blai30/pcbs/boards/fuji75-pcb/reference/j1-probe-guide.png

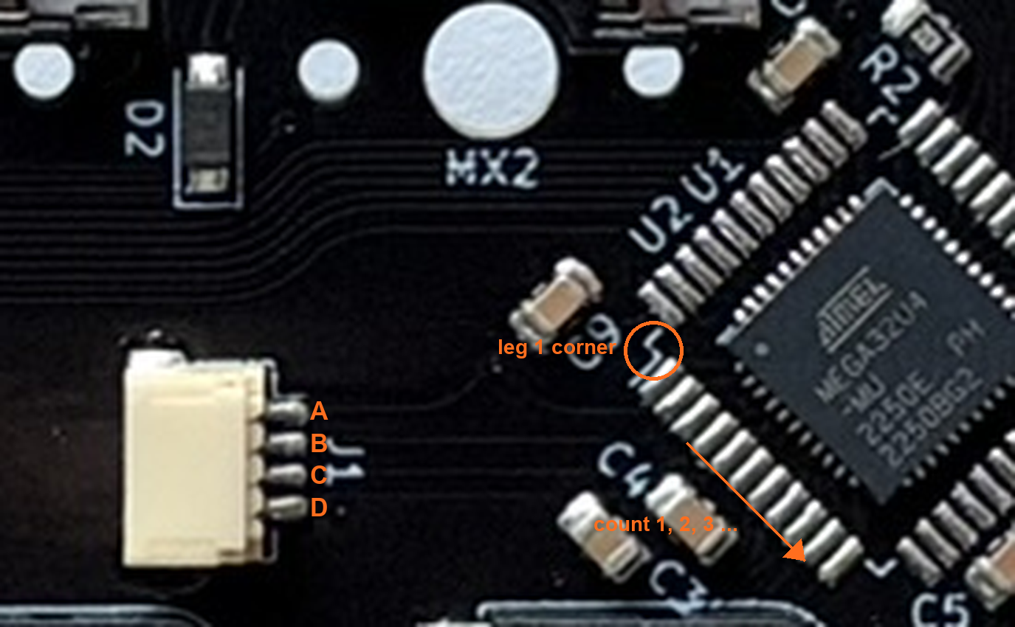
boards/fuji75-pcb/reference/j1-probe-guide.png
