blai30/pcbs/boards/fuji75-pcb/reference/photos/IMG_5499.JPEG

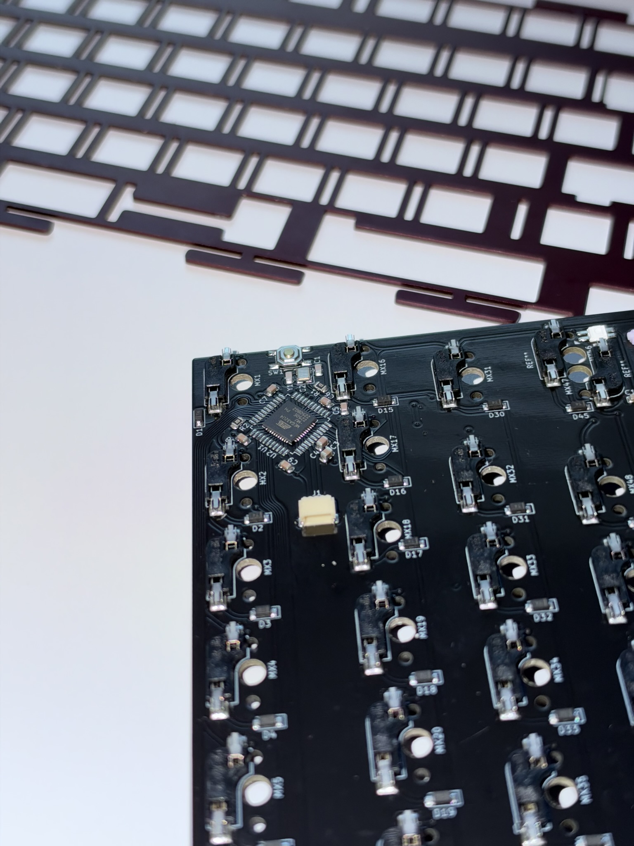
boards/fuji75-pcb/reference/photos/IMG_5499.JPEG
