blai30/pcbs/boards/fuji75-pcb/reference/keyboard-layout.png

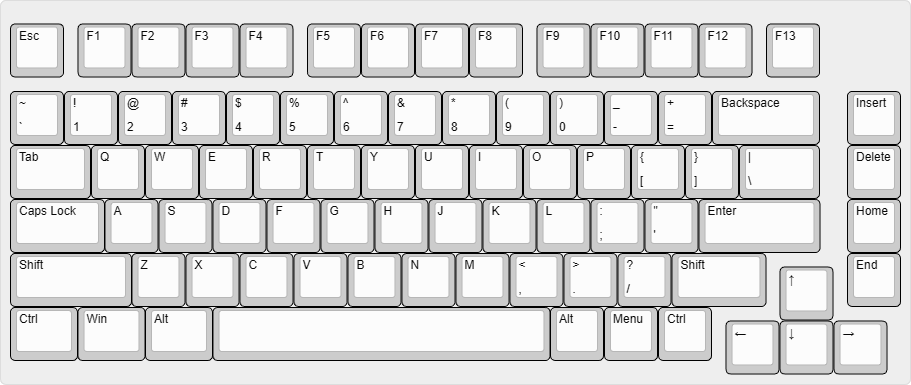
boards/fuji75-pcb/reference/keyboard-layout.png
