blai30/pcbs/boards/fuji75-pcb/reference/photos/IMG_5492.JPEG

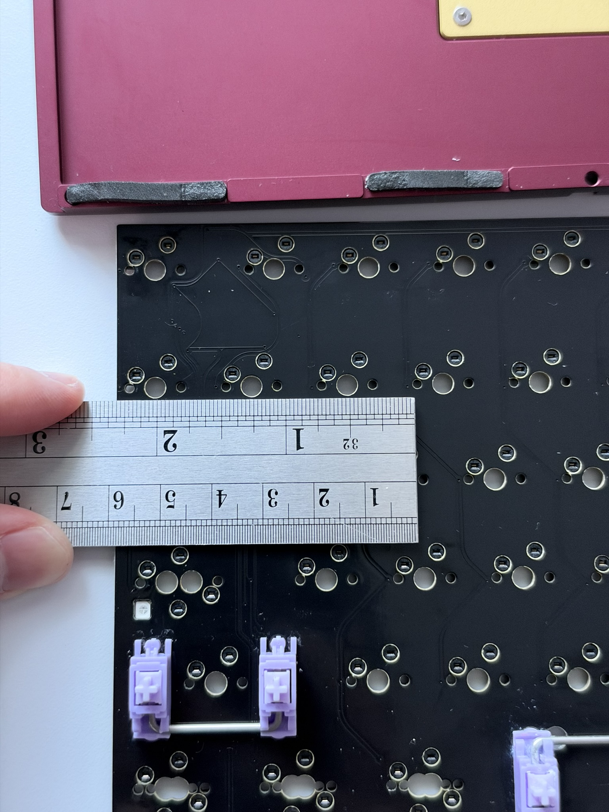
boards/fuji75-pcb/reference/photos/IMG_5492.JPEG
