blai30/pcbs/boards/fuji75-pcb/reference/photos/IMG_5493.JPEG

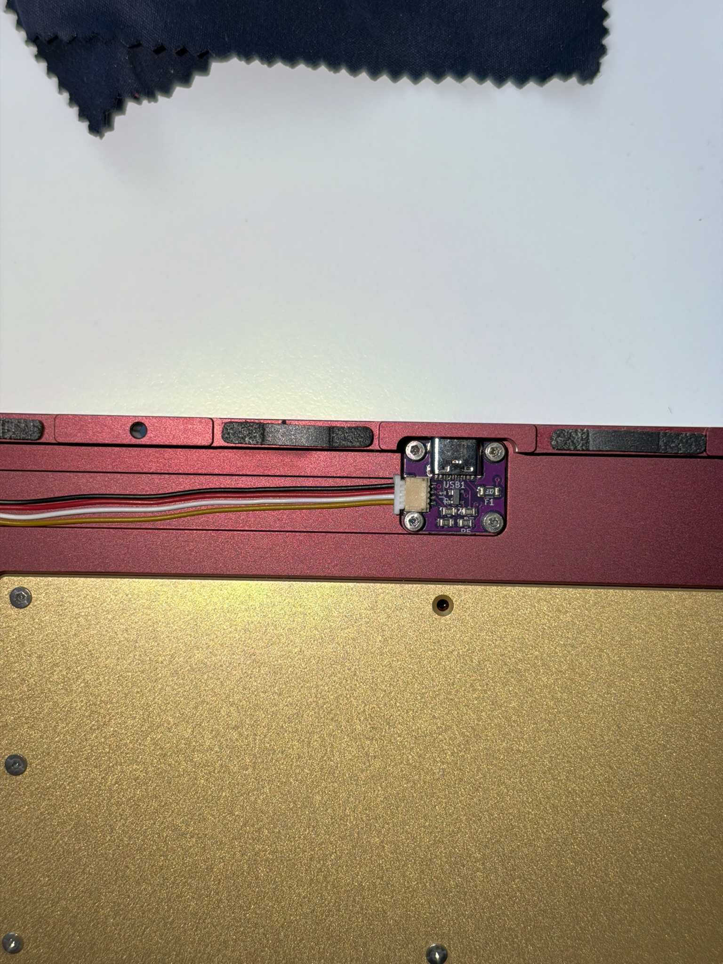
boards/fuji75-pcb/reference/photos/IMG_5493.JPEG
