blai30/pcbs/boards/fuji75-pcb/fuji75_plate.dxf

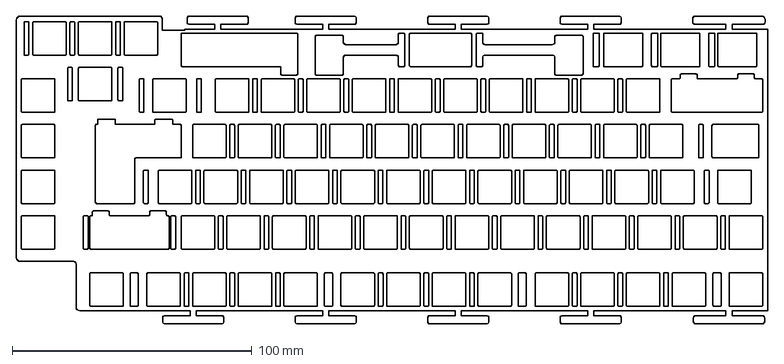
[picture p20: CAD file, 2026-11-05]
boards/fuji75-pcb/fuji75_plate.dxf
313.3 x 128.4 mm
