blai30/pcbs/boards/fuji75-pcb/plate/fuji75-plate-foam.dxf

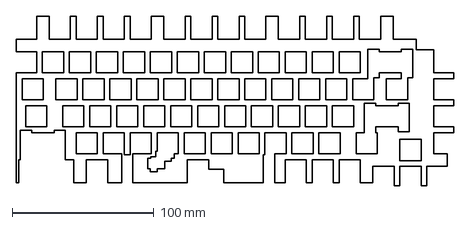
[picture p21: CAD file, 2026-11-10]
boards/fuji75-pcb/plate/fuji75-plate-foam.dxf
309.1 x 119.9 mm
