blai30/pcbs/boards/fuji75-pcb/reference/measurement-guide.png

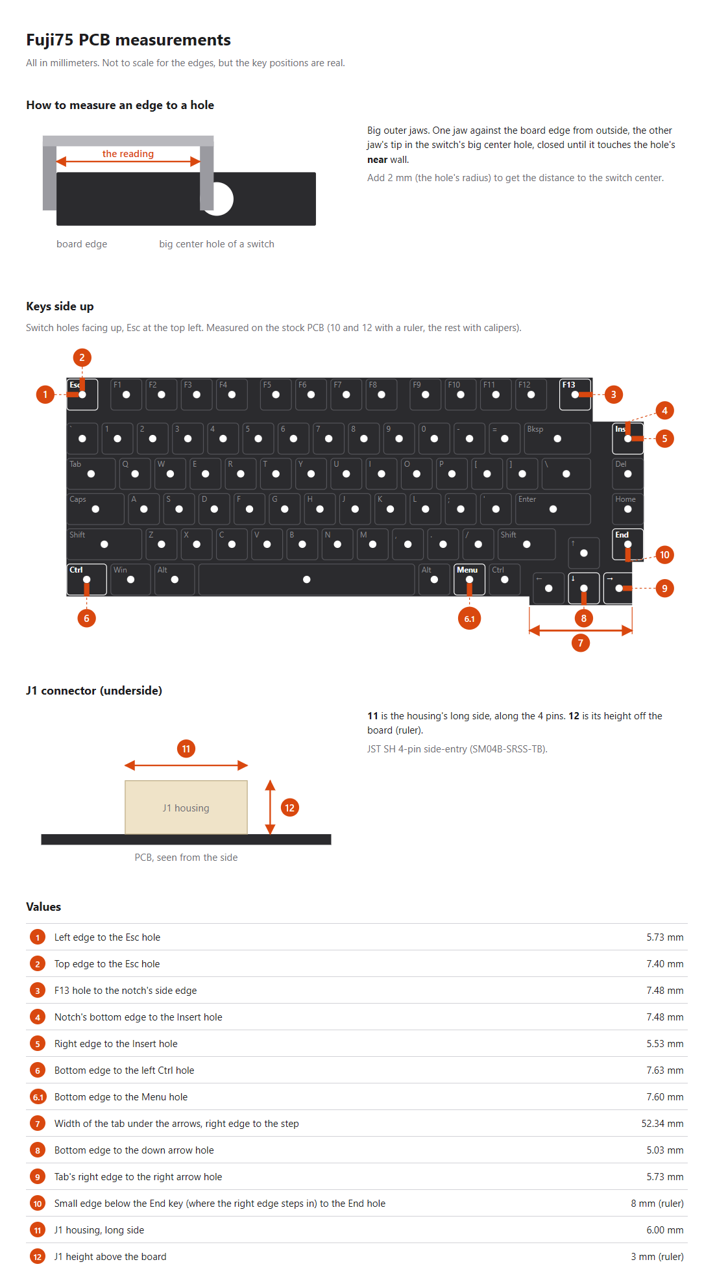
boards/fuji75-pcb/reference/measurement-guide.png
