blai30/pcbs/boards/fuji75-pcb/reference/measurements.md

# PCB edge distance
1. Left edge to near edge of ESC switch center hole: 5.73 mm
2. Top edge to near edge of ESC switch center hole: 7.40 mm
3. Indented right edge to near edge of F13 switch center hole: 7.48 mm
4. Indented top edge to near edge of Ins switch center hole: 7.48 mm
5. Right edge to near edge of Ins switch center hole: 5.53 mm
6. Bottom edge to near edge of Left Ctrl switch center hole: 7.63 mm
  6.1. Bottom edge to near edge of Right Menu switch center hole: 7.60 mm
7. Right edge to indented left edge; arrow keys plateau: 52.34 mm (calipers) / 52 mm (ruler)
8. Extended bottom edge to Down Arrow switch center hole: 5.03 mm
9. Short indented right edge to Right Arrow switch center hole: 5.73 mm
10. Indented bottom edge to End switch center hole: 8 mm (ruler)

# J1 connector
11. J1 connector housing long side: 6.00 mm
12. J1 connector housing height: 3 mm (ruler)
