blai30/pcbs/boards/fuji75-pcb/fuji75.kicad_pcb

## KiCad design boards/fuji75-pcb/fuji75.kicad_pcb (2026-11-06)

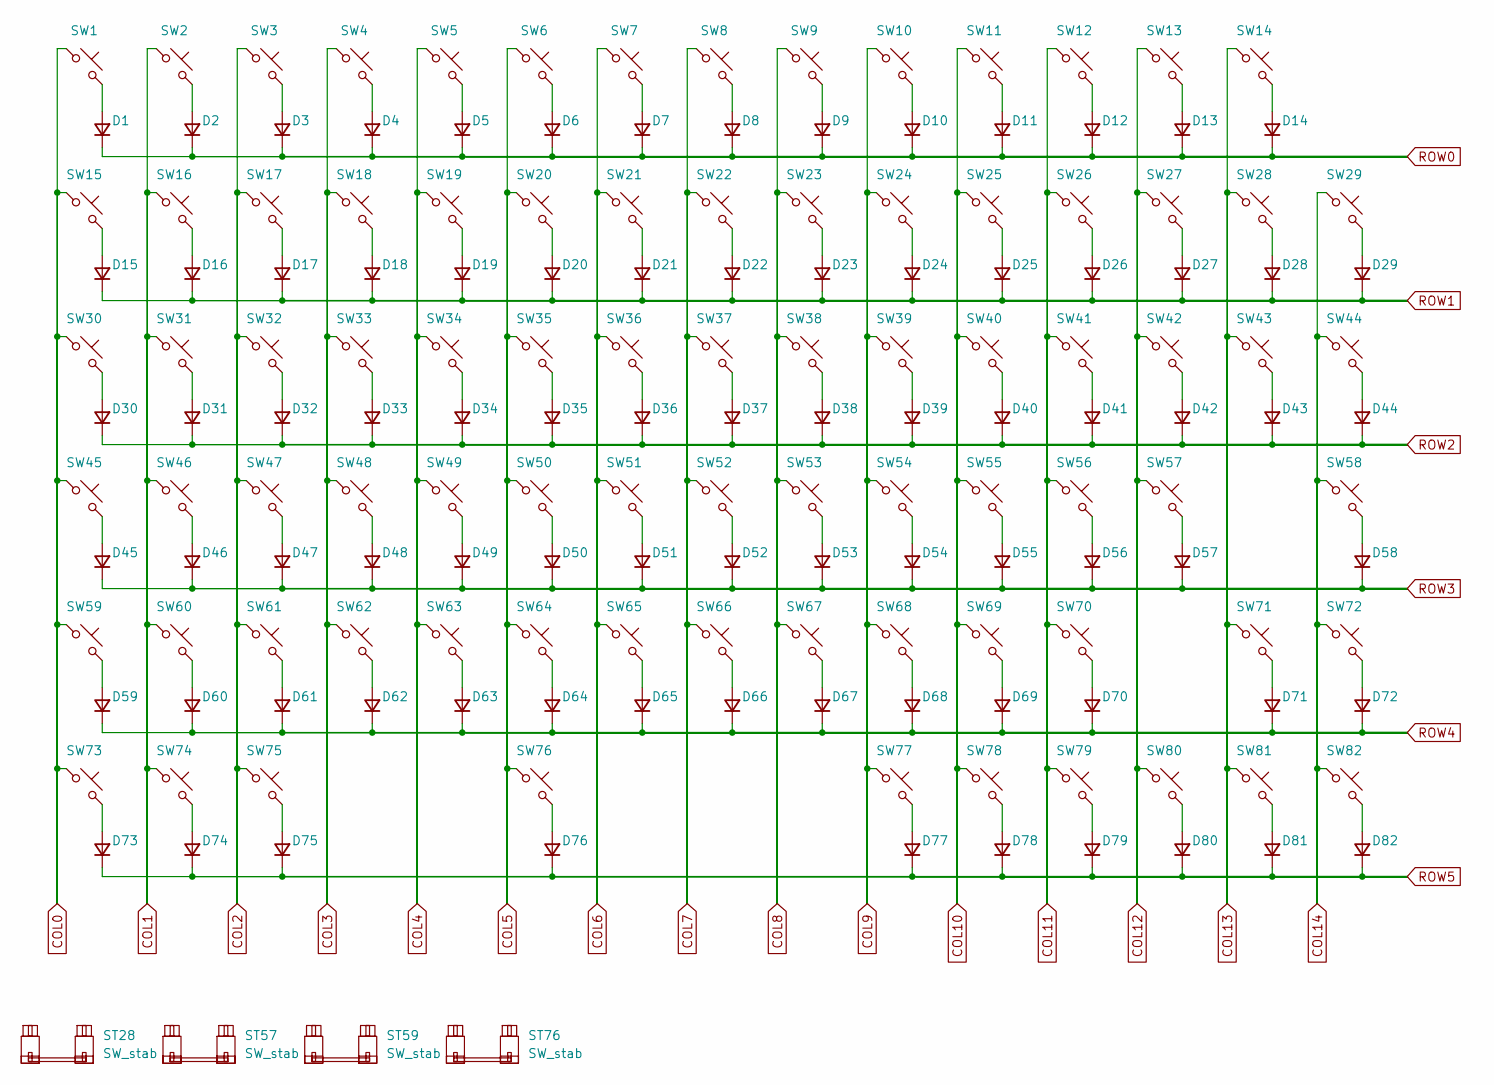
[picture p23: schematic fuji75-key-matrix.kicad_sch]

Parts:
D1, D2, D3, D4, D5, D6, D7, D8, D9, D10, D11, D12, D13, D14, D15, D16, D17, D18, D19, D20, D21, D22, D23, D24, D25, D26, D27, D28, D29, D30, D31, D32, D33, D34, D35, D36, D37, D38, D39, D40, D41, D42, D43, D44, D45, D46, D47, D48, D49, D50, D51, D52, D53, D54, D55, D56, D57, D58, D59, D60, D61, D62, D63, D64, D65, D66, D67, D68, D69, D70, D71, D72, D73, D74, D75, D76, D77, D78, D79, D80, D81, D82: D; D_SOD-123; MPN 1N4148W; LCSC C81598
ST28: SW_stab; STAB_MX_2u
ST57, ST59: SW_stab; STAB_MX_2.25u
ST76: SW_stab; STAB_MX_6.25u
SW1, SW2, SW3, SW4, SW5, SW6, SW7, SW8, SW9, SW10, SW11, SW12, SW13, SW14, SW15, SW16, SW17, SW18, SW19, SW20, SW21, SW22, SW23, SW24, SW25, SW26, SW27, SW28, SW29, SW31, SW32, SW33, SW34, SW35, SW36, SW37, SW38, SW39, SW40, SW41, SW42, SW44, SW46, SW47, SW48, SW49, SW50, SW51, SW52, SW53, SW54, SW55, SW56, SW57, SW58, SW59, SW60, SW61, SW62, SW63, SW64, SW65, SW66, SW67, SW68, SW69, SW71, SW72, SW76, SW77, SW78, SW79, SW80, SW81, SW82: SW_Push; SW_MX_HS_CPG151101S11_1u; MPN CPG151101S11; LCSC C2803348
SW30, SW43: SW_Push; SW_MX_HS_CPG151101S11_1.5u; MPN CPG151101S11; LCSC C2803348
SW45, SW70: SW_Push; SW_MX_HS_CPG151101S11_1.75u; MPN CPG151101S11; LCSC C2803348
SW73, SW74, SW75: SW_Push; SW_MX_HS_CPG151101S11_1.25u; MPN CPG151101S11; LCSC C2803348

Connections:
COL0: SW1.1, SW15.1, SW30.1, SW45.1, SW59.1, SW73.1; also elsewhere on the board
COL1: SW2.1, SW16.1, SW31.1, SW46.1, SW60.1, SW74.1; also elsewhere on the board
COL2: SW3.1, SW17.1, SW32.1, SW47.1, SW61.1, SW75.1; also elsewhere on the board
COL3: SW4.1, SW18.1, SW33.1, SW48.1, SW62.1; also elsewhere on the board
COL4: SW5.1, SW19.1, SW34.1, SW49.1, SW63.1; also elsewhere on the board
COL5: SW6.1, SW20.1, SW35.1, SW50.1, SW64.1, SW76.1; also elsewhere on the board
COL6: SW7.1, SW21.1, SW36.1, SW51.1, SW65.1; also elsewhere on the board
COL7: SW8.1, SW22.1, SW37.1, SW52.1, SW66.1; also elsewhere on the board
COL8: SW9.1, SW23.1, SW38.1, SW53.1, SW67.1; also elsewhere on the board
COL9: SW10.1, SW24.1, SW39.1, SW54.1, SW68.1, SW77.1; also elsewhere on the board
COL10: SW11.1, SW25.1, SW40.1, SW55.1, SW69.1, SW78.1; also elsewhere on the board
COL11: SW12.1, SW26.1, SW41.1, SW56.1, SW70.1, SW79.1; also elsewhere on the board
COL12: SW13.1, SW27.1, SW42.1, SW57.1, SW80.1; also elsewhere on the board
COL13: SW14.1, SW28.1, SW43.1, SW71.1, SW81.1; also elsewhere on the board
COL14: SW29.1, SW44.1, SW58.1, SW72.1, SW82.1; also elsewhere on the board
unnamed: D1.2 (A), SW1.2
unnamed: D2.2 (A), SW2.2
unnamed: D3.2 (A), SW3.2
unnamed: D4.2 (A), SW4.2
unnamed: D5.2 (A), SW5.2
unnamed: D6.2 (A), SW6.2
unnamed: D7.2 (A), SW7.2
unnamed: D8.2 (A), SW8.2
unnamed: D9.2 (A), SW9.2
unnamed: D10.2 (A), SW10.2
unnamed: D11.2 (A), SW11.2
unnamed: D12.2 (A), SW12.2
unnamed: D13.2 (A), SW13.2
unnamed: D14.2 (A), SW14.2
unnamed: D15.2 (A), SW15.2
unnamed: D16.2 (A), SW16.2
unnamed: D17.2 (A), SW17.2
unnamed: D18.2 (A), SW18.2
unnamed: D19.2 (A), SW19.2
unnamed: D20.2 (A), SW20.2
unnamed: D21.2 (A), SW21.2
unnamed: D22.2 (A), SW22.2
unnamed: D23.2 (A), SW23.2
unnamed: D24.2 (A), SW24.2
unnamed: D25.2 (A), SW25.2
unnamed: D26.2 (A), SW26.2
unnamed: D27.2 (A), SW27.2
unnamed: D28.2 (A), SW28.2
unnamed: D29.2 (A), SW29.2
unnamed: D30.2 (A), SW30.2
unnamed: D31.2 (A), SW31.2
unnamed: D32.2 (A), SW32.2
unnamed: D33.2 (A), SW33.2
unnamed: D34.2 (A), SW34.2
unnamed: D35.2 (A), SW35.2
unnamed: D36.2 (A), SW36.2
unnamed: D37.2 (A), SW37.2
unnamed: D38.2 (A), SW38.2
unnamed: D39.2 (A), SW39.2
unnamed: D40.2 (A), SW40.2
unnamed: D41.2 (A), SW41.2
unnamed: D42.2 (A), SW42.2
unnamed: D43.2 (A), SW43.2
unnamed: D44.2 (A), SW44.2
unnamed: D45.2 (A), SW45.2
unnamed: D46.2 (A), SW46.2
unnamed: D47.2 (A), SW47.2
unnamed: D48.2 (A), SW48.2
unnamed: D49.2 (A), SW49.2
unnamed: D50.2 (A), SW50.2
unnamed: D51.2 (A), SW51.2
unnamed: D52.2 (A), SW52.2
unnamed: D53.2 (A), SW53.2
unnamed: D54.2 (A), SW54.2
unnamed: D55.2 (A), SW55.2
unnamed: D56.2 (A), SW56.2
unnamed: D57.2 (A), SW57.2
unnamed: D58.2 (A), SW58.2
unnamed: D59.2 (A), SW59.2
unnamed: D60.2 (A), SW60.2
unnamed: D61.2 (A), SW61.2
unnamed: D62.2 (A), SW62.2
unnamed: D63.2 (A), SW63.2
unnamed: D64.2 (A), SW64.2
unnamed: D65.2 (A), SW65.2
unnamed: D66.2 (A), SW66.2
unnamed: D67.2 (A), SW67.2
unnamed: D68.2 (A), SW68.2
unnamed: D69.2 (A), SW69.2
unnamed: D70.2 (A), SW70.2
unnamed: D71.2 (A), SW71.2
unnamed: D72.2 (A), SW72.2
unnamed: D73.2 (A), SW73.2
unnamed: D74.2 (A), SW74.2
unnamed: D75.2 (A), SW75.2
unnamed: D76.2 (A), SW76.2
unnamed: D77.2 (A), SW77.2
unnamed: D78.2 (A), SW78.2
unnamed: D79.2 (A), SW79.2
unnamed: D80.2 (A), SW80.2
unnamed: D81.2 (A), SW81.2
unnamed: D82.2 (A), SW82.2
ROW0: D1.1 (K), D2.1 (K), D3.1 (K), D4.1 (K), D5.1 (K), D6.1 (K), D7.1 (K), D8.1 (K), D9.1 (K), D10.1 (K), D11.1 (K), D12.1 (K), D13.1 (K), D14.1 (K); also elsewhere on the board
ROW1: D15.1 (K), D16.1 (K), D17.1 (K), D18.1 (K), D19.1 (K), D20.1 (K), D21.1 (K), D22.1 (K), D23.1 (K), D24.1 (K), D25.1 (K), D26.1 (K), D27.1 (K), D28.1 (K), D29.1 (K); also elsewhere on the board
ROW2: D30.1 (K), D31.1 (K), D32.1 (K), D33.1 (K), D34.1 (K), D35.1 (K), D36.1 (K), D37.1 (K), D38.1 (K), D39.1 (K), D40.1 (K), D41.1 (K), D42.1 (K), D43.1 (K), D44.1 (K); also elsewhere on the board
ROW3: D45.1 (K), D46.1 (K), D47.1 (K), D48.1 (K), D49.1 (K), D50.1 (K), D51.1 (K), D52.1 (K), D53.1 (K), D54.1 (K), D55.1 (K), D56.1 (K), D57.1 (K), D58.1 (K); also elsewhere on the board
ROW4: D59.1 (K), D60.1 (K), D61.1 (K), D62.1 (K), D63.1 (K), D64.1 (K), D65.1 (K), D66.1 (K), D67.1 (K), D68.1 (K), D69.1 (K), D70.1 (K), D71.1 (K), D72.1 (K); also elsewhere on the board
ROW5: D73.1 (K), D74.1 (K), D75.1 (K), D76.1 (K), D77.1 (K), D78.1 (K), D79.1 (K), D80.1 (K), D81.1 (K), D82.1 (K); also elsewhere on the board

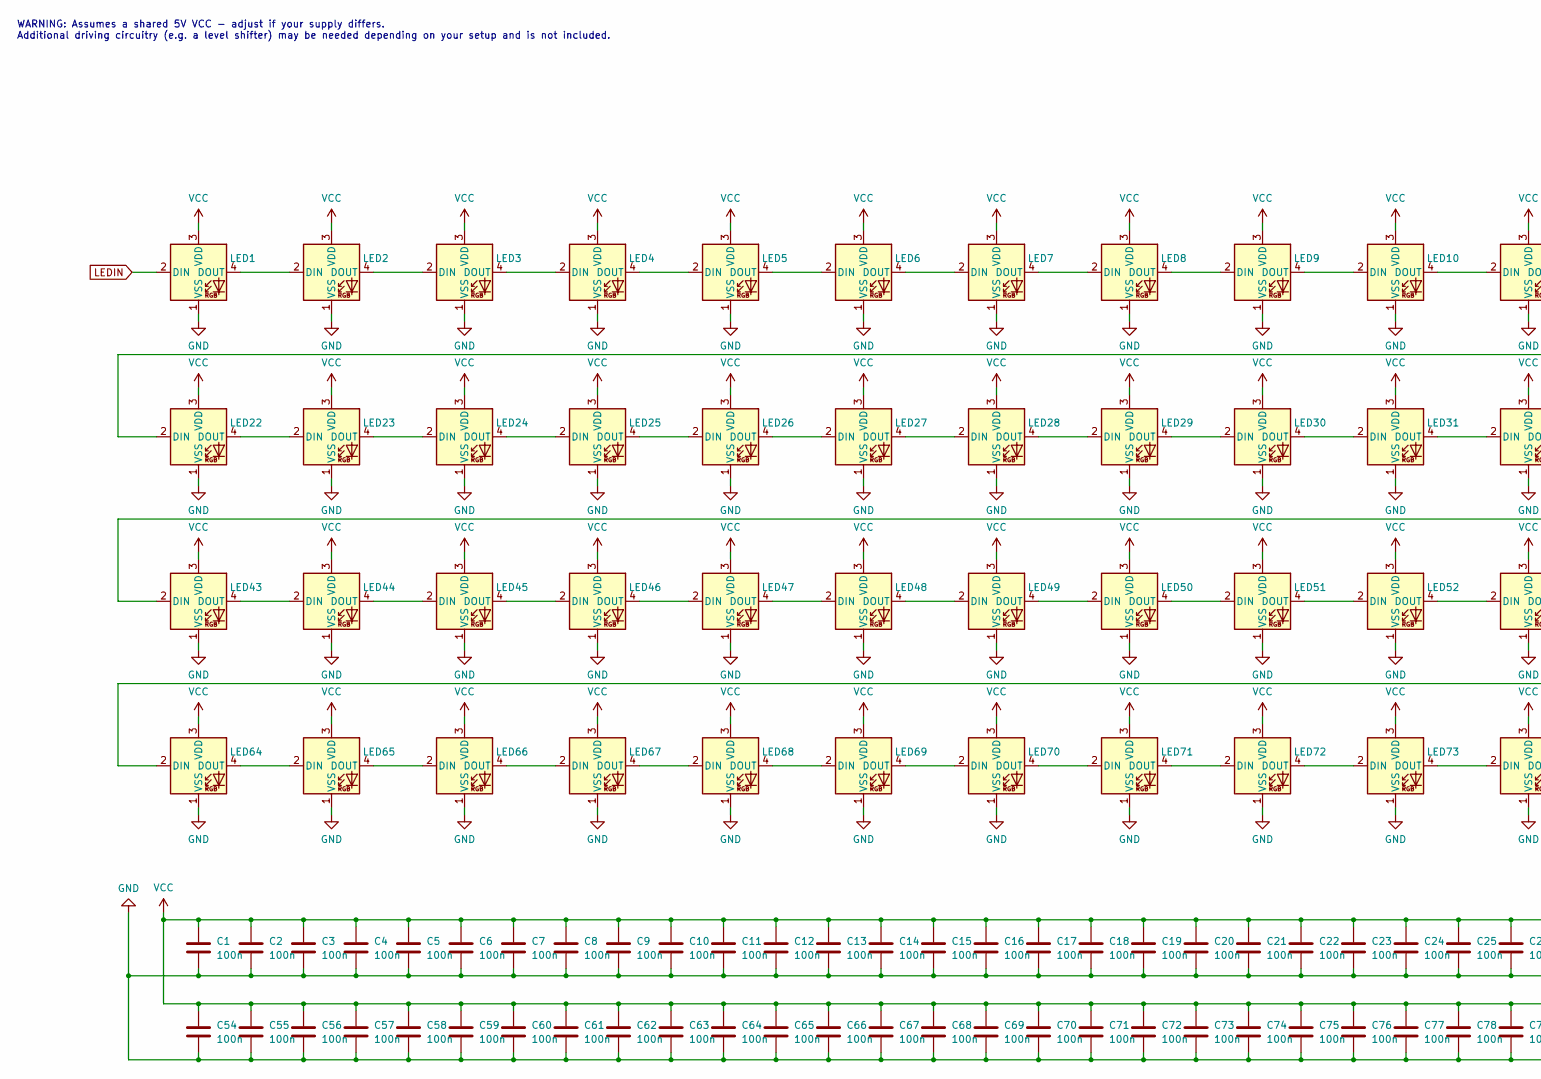
[picture p24: schematic fuji75-led-chain.kicad_sch, part in row 1, column 1]

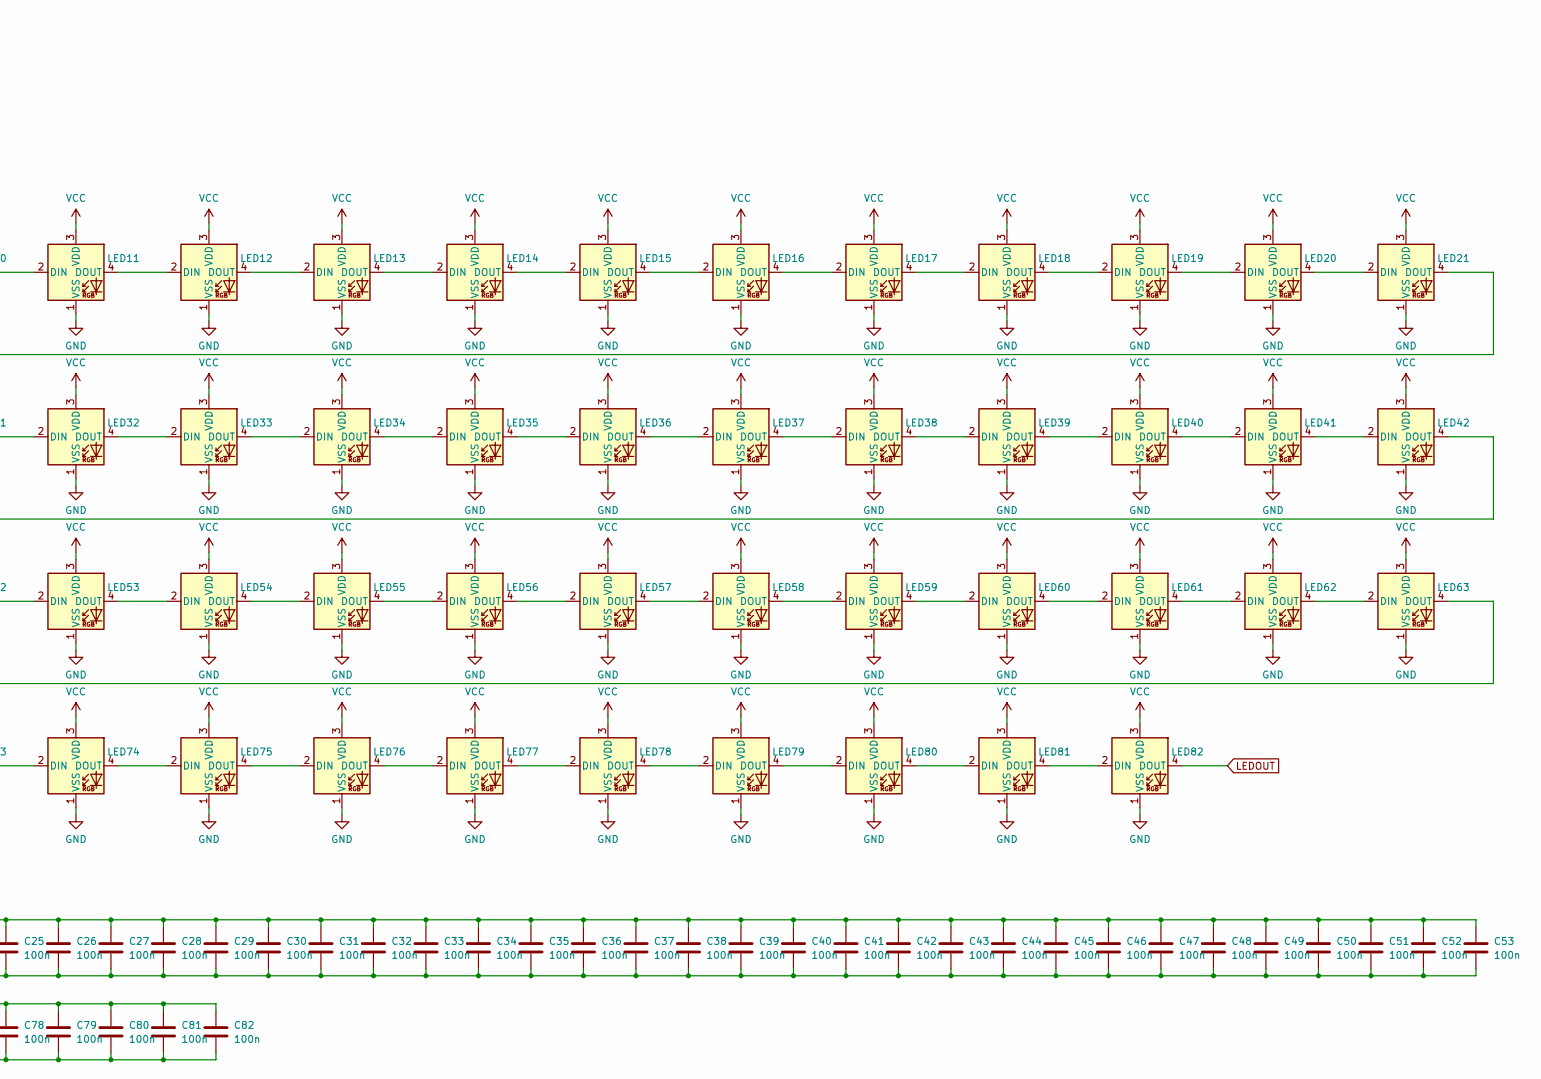
[picture p25: schematic fuji75-led-chain.kicad_sch, part in row 1, column 2]

Parts:
C1, C2, C3, C4, C5, C6, C7, C8, C9, C10, C11, C12, C13, C14, C15, C16, C17, C18, C19, C20, C21, C22, C23, C24, C25, C26, C27, C28, C29, C30, C31, C32, C33, C34, C35, C36, C37, C38, C39, C40, C41, C42, C43, C44, C45, C46, C47, C48, C49, C50, C51, C52, C53, C54, C55, C56, C57, C58, C59, C60, C61, C62, C63, C64, C65, C66, C67, C68, C69, C70, C71, C72, C73, C74, C75, C76, C77, C78, C79, C80, C81, C82: 100n; C_0402_1005Metric; MPN CL05B104KO5NNNC; LCSC C1525
LED1, LED2, LED3, LED4, LED5, LED6, LED7, LED8, LED9, LED10, LED11, LED12, LED13, LED14, LED15, LED16, LED17, LED18, LED19, LED20, LED21, LED22, LED23, LED24, LED25, LED26, LED27, LED28, LED29, LED30, LED31, LED32, LED33, LED34, LED35, LED36, LED37, LED38, LED39, LED40, LED41, LED42, LED43, LED44, LED45, LED46, LED47, LED48, LED49, LED50, LED51, LED52, LED53, LED54, LED55, LED56, LED57, LED58, LED59, LED60, LED61, LED62, LED63, LED64, LED65, LED66, LED67, LED68, LED69, LED70, LED71, LED72, LED73, LED74, LED75, LED76, LED77, LED78, LED79, LED80, LED81, LED82: SK6812MINI-E; LED_MX_6028R; MPN SK6812MINI-E; LCSC C5149201

Connections:
GND: C1.2, C2.2, C3.2, C4.2, C5.2, C6.2, C7.2, C8.2, C9.2, C10.2, C11.2, C12.2, C13.2, C14.2, C15.2, C16.2, C17.2, C18.2, C19.2, C20.2, C21.2, C22.2, C23.2, C24.2, C25.2, C26.2, C27.2, C28.2, C29.2, C30.2, C31.2, C32.2, C33.2, C34.2, C35.2, C36.2, C37.2, C38.2, C39.2, C40.2, C41.2, C42.2, C43.2, C44.2, C45.2, C46.2, C47.2, C48.2, C49.2, C50.2, C51.2, C52.2, C53.2, C54.2, C55.2, C56.2, C57.2, C58.2, C59.2, C60.2, C61.2, C62.2, C63.2, C64.2, C65.2, C66.2, C67.2, C68.2, C69.2, C70.2, C71.2, C72.2, C73.2, C74.2, C75.2, C76.2, C77.2, C78.2, C79.2, C80.2, C81.2, C82.2, LED1.1 (VSS), LED2.1 (VSS), LED3.1 (VSS), LED4.1 (VSS), LED5.1 (VSS), LED6.1 (VSS), LED7.1 (VSS), LED8.1 (VSS), LED9.1 (VSS), LED10.1 (VSS), LED11.1 (VSS), LED12.1 (VSS), LED13.1 (VSS), LED14.1 (VSS), LED15.1 (VSS), LED16.1 (VSS), LED17.1 (VSS), LED18.1 (VSS), LED19.1 (VSS), LED20.1 (VSS), LED21.1 (VSS), LED22.1 (VSS), LED23.1 (VSS), LED24.1 (VSS), LED25.1 (VSS), LED26.1 (VSS), LED27.1 (VSS), LED28.1 (VSS), LED29.1 (VSS), LED30.1 (VSS), LED31.1 (VSS), LED32.1 (VSS), LED33.1 (VSS), LED34.1 (VSS), LED35.1 (VSS), LED36.1 (VSS), LED37.1 (VSS), LED38.1 (VSS), LED39.1 (VSS), LED40.1 (VSS), LED41.1 (VSS), LED42.1 (VSS), LED43.1 (VSS), LED44.1 (VSS), LED45.1 (VSS), LED46.1 (VSS), LED47.1 (VSS), LED48.1 (VSS), LED49.1 (VSS), LED50.1 (VSS), LED51.1 (VSS), LED52.1 (VSS), LED53.1 (VSS), LED54.1 (VSS), LED55.1 (VSS), LED56.1 (VSS), LED57.1 (VSS), LED58.1 (VSS), LED59.1 (VSS), LED60.1 (VSS), LED61.1 (VSS), LED62.1 (VSS), LED63.1 (VSS), LED64.1 (VSS), LED65.1 (VSS), LED66.1 (VSS), LED67.1 (VSS), LED68.1 (VSS), LED69.1 (VSS), LED70.1 (VSS), LED71.1 (VSS), LED72.1 (VSS), LED73.1 (VSS), LED74.1 (VSS), LED75.1 (VSS), LED76.1 (VSS), LED77.1 (VSS), LED78.1 (VSS), LED79.1 (VSS), LED80.1 (VSS), LED81.1 (VSS), LED82.1 (VSS); also elsewhere on the board
LEDIN: LED1.2 (DIN); also elsewhere on the board
LEDOUT: LED82.4 (DOUT)
unnamed: LED1.4 (DOUT), LED2.2 (DIN)
unnamed: LED2.4 (DOUT), LED3.2 (DIN)
unnamed: LED3.4 (DOUT), LED4.2 (DIN)
unnamed: LED4.4 (DOUT), LED5.2 (DIN)
unnamed: LED5.4 (DOUT), LED6.2 (DIN)
unnamed: LED6.4 (DOUT), LED7.2 (DIN)
unnamed: LED7.4 (DOUT), LED8.2 (DIN)
unnamed: LED8.4 (DOUT), LED9.2 (DIN)
unnamed: LED9.4 (DOUT), LED10.2 (DIN)
unnamed: LED10.4 (DOUT), LED11.2 (DIN)
unnamed: LED11.4 (DOUT), LED12.2 (DIN)
unnamed: LED12.4 (DOUT), LED13.2 (DIN)
unnamed: LED13.4 (DOUT), LED14.2 (DIN)
unnamed: LED14.4 (DOUT), LED15.2 (DIN)
unnamed: LED15.4 (DOUT), LED16.2 (DIN)
unnamed: LED16.4 (DOUT), LED17.2 (DIN)
unnamed: LED17.4 (DOUT), LED18.2 (DIN)
unnamed: LED18.4 (DOUT), LED19.2 (DIN)
unnamed: LED19.4 (DOUT), LED20.2 (DIN)
unnamed: LED20.4 (DOUT), LED21.2 (DIN)
unnamed: LED21.4 (DOUT), LED22.2 (DIN)
unnamed: LED22.4 (DOUT), LED23.2 (DIN)
unnamed: LED23.4 (DOUT), LED24.2 (DIN)
unnamed: LED24.4 (DOUT), LED25.2 (DIN)
unnamed: LED25.4 (DOUT), LED26.2 (DIN)
unnamed: LED26.4 (DOUT), LED27.2 (DIN)
unnamed: LED27.4 (DOUT), LED28.2 (DIN)
unnamed: LED28.4 (DOUT), LED29.2 (DIN)
unnamed: LED29.4 (DOUT), LED30.2 (DIN)
unnamed: LED30.4 (DOUT), LED31.2 (DIN)
unnamed: LED31.4 (DOUT), LED32.2 (DIN)
unnamed: LED32.4 (DOUT), LED33.2 (DIN)
unnamed: LED33.4 (DOUT), LED34.2 (DIN)
unnamed: LED34.4 (DOUT), LED35.2 (DIN)
unnamed: LED35.4 (DOUT), LED36.2 (DIN)
unnamed: LED36.4 (DOUT), LED37.2 (DIN)
unnamed: LED37.4 (DOUT), LED38.2 (DIN)
unnamed: LED38.4 (DOUT), LED39.2 (DIN)
unnamed: LED39.4 (DOUT), LED40.2 (DIN)
unnamed: LED40.4 (DOUT), LED41.2 (DIN)
unnamed: LED41.4 (DOUT), LED42.2 (DIN)
unnamed: LED42.4 (DOUT), LED43.2 (DIN)
unnamed: LED43.4 (DOUT), LED44.2 (DIN)
unnamed: LED44.4 (DOUT), LED45.2 (DIN)
unnamed: LED45.4 (DOUT), LED46.2 (DIN)
unnamed: LED46.4 (DOUT), LED47.2 (DIN)
unnamed: LED47.4 (DOUT), LED48.2 (DIN)
unnamed: LED48.4 (DOUT), LED49.2 (DIN)
unnamed: LED49.4 (DOUT), LED50.2 (DIN)
unnamed: LED50.4 (DOUT), LED51.2 (DIN)
unnamed: LED51.4 (DOUT), LED52.2 (DIN)
unnamed: LED52.4 (DOUT), LED53.2 (DIN)
unnamed: LED53.4 (DOUT), LED54.2 (DIN)
unnamed: LED54.4 (DOUT), LED55.2 (DIN)
unnamed: LED55.4 (DOUT), LED56.2 (DIN)
unnamed: LED56.4 (DOUT), LED57.2 (DIN)
unnamed: LED57.4 (DOUT), LED58.2 (DIN)
unnamed: LED58.4 (DOUT), LED59.2 (DIN)
unnamed: LED59.4 (DOUT), LED60.2 (DIN)
unnamed: LED60.4 (DOUT), LED61.2 (DIN)
unnamed: LED61.4 (DOUT), LED62.2 (DIN)
unnamed: LED62.4 (DOUT), LED63.2 (DIN)
unnamed: LED63.4 (DOUT), LED64.2 (DIN)
unnamed: LED64.4 (DOUT), LED65.2 (DIN)
unnamed: LED65.4 (DOUT), LED66.2 (DIN)
unnamed: LED66.4 (DOUT), LED67.2 (DIN)
unnamed: LED67.4 (DOUT), LED68.2 (DIN)
unnamed: LED68.4 (DOUT), LED69.2 (DIN)
unnamed: LED69.4 (DOUT), LED70.2 (DIN)
unnamed: LED70.4 (DOUT), LED71.2 (DIN)
unnamed: LED71.4 (DOUT), LED72.2 (DIN)
unnamed: LED72.4 (DOUT), LED73.2 (DIN)
unnamed: LED73.4 (DOUT), LED74.2 (DIN)
unnamed: LED74.4 (DOUT), LED75.2 (DIN)
unnamed: LED75.4 (DOUT), LED76.2 (DIN)
unnamed: LED76.4 (DOUT), LED77.2 (DIN)
unnamed: LED77.4 (DOUT), LED78.2 (DIN)
unnamed: LED78.4 (DOUT), LED79.2 (DIN)
unnamed: LED79.4 (DOUT), LED80.2 (DIN)
unnamed: LED80.4 (DOUT), LED81.2 (DIN)
unnamed: LED81.4 (DOUT), LED82.2 (DIN)
VCC: C1.1, C2.1, C3.1, C4.1, C5.1, C6.1, C7.1, C8.1, C9.1, C10.1, C11.1, C12.1, C13.1, C14.1, C15.1, C16.1, C17.1, C18.1, C19.1, C20.1, C21.1, C22.1, C23.1, C24.1, C25.1, C26.1, C27.1, C28.1, C29.1, C30.1, C31.1, C32.1, C33.1, C34.1, C35.1, C36.1, C37.1, C38.1, C39.1, C40.1, C41.1, C42.1, C43.1, C44.1, C45.1, C46.1, C47.1, C48.1, C49.1, C50.1, C51.1, C52.1, C53.1, C54.1, C55.1, C56.1, C57.1, C58.1, C59.1, C60.1, C61.1, C62.1, C63.1, C64.1, C65.1, C66.1, C67.1, C68.1, C69.1, C70.1, C71.1, C72.1, C73.1, C74.1, C75.1, C76.1, C77.1, C78.1, C79.1, C80.1, C81.1, C82.1, LED1.3 (VDD), LED2.3 (VDD), LED3.3 (VDD), LED4.3 (VDD), LED5.3 (VDD), LED6.3 (VDD), LED7.3 (VDD), LED8.3 (VDD), LED9.3 (VDD), LED10.3 (VDD), LED11.3 (VDD), LED12.3 (VDD), LED13.3 (VDD), LED14.3 (VDD), LED15.3 (VDD), LED16.3 (VDD), LED17.3 (VDD), LED18.3 (VDD), LED19.3 (VDD), LED20.3 (VDD), LED21.3 (VDD), LED22.3 (VDD), LED23.3 (VDD), LED24.3 (VDD), LED25.3 (VDD), LED26.3 (VDD), LED27.3 (VDD), LED28.3 (VDD), LED29.3 (VDD), LED30.3 (VDD), LED31.3 (VDD), LED32.3 (VDD), LED33.3 (VDD), LED34.3 (VDD), LED35.3 (VDD), LED36.3 (VDD), LED37.3 (VDD), LED38.3 (VDD), LED39.3 (VDD), LED40.3 (VDD), LED41.3 (VDD), LED42.3 (VDD), LED43.3 (VDD), LED44.3 (VDD), LED45.3 (VDD), LED46.3 (VDD), LED47.3 (VDD), LED48.3 (VDD), LED49.3 (VDD), LED50.3 (VDD), LED51.3 (VDD), LED52.3 (VDD), LED53.3 (VDD), LED54.3 (VDD), LED55.3 (VDD), LED56.3 (VDD), LED57.3 (VDD), LED58.3 (VDD), LED59.3 (VDD), LED60.3 (VDD), LED61.3 (VDD), LED62.3 (VDD), LED63.3 (VDD), LED64.3 (VDD), LED65.3 (VDD), LED66.3 (VDD), LED67.3 (VDD), LED68.3 (VDD), LED69.3 (VDD), LED70.3 (VDD), LED71.3 (VDD), LED72.3 (VDD), LED73.3 (VDD), LED74.3 (VDD), LED75.3 (VDD), LED76.3 (VDD), LED77.3 (VDD), LED78.3 (VDD), LED79.3 (VDD), LED80.3 (VDD), LED81.3 (VDD), LED82.3 (VDD); also elsewhere on the board

Notes on the sheet:
WARNING: Assumes a shared 5V VCC - adjust if your supply differs. Additional driving circuitry (e.g. a level shifter) may be needed depending on your setup and is not included.

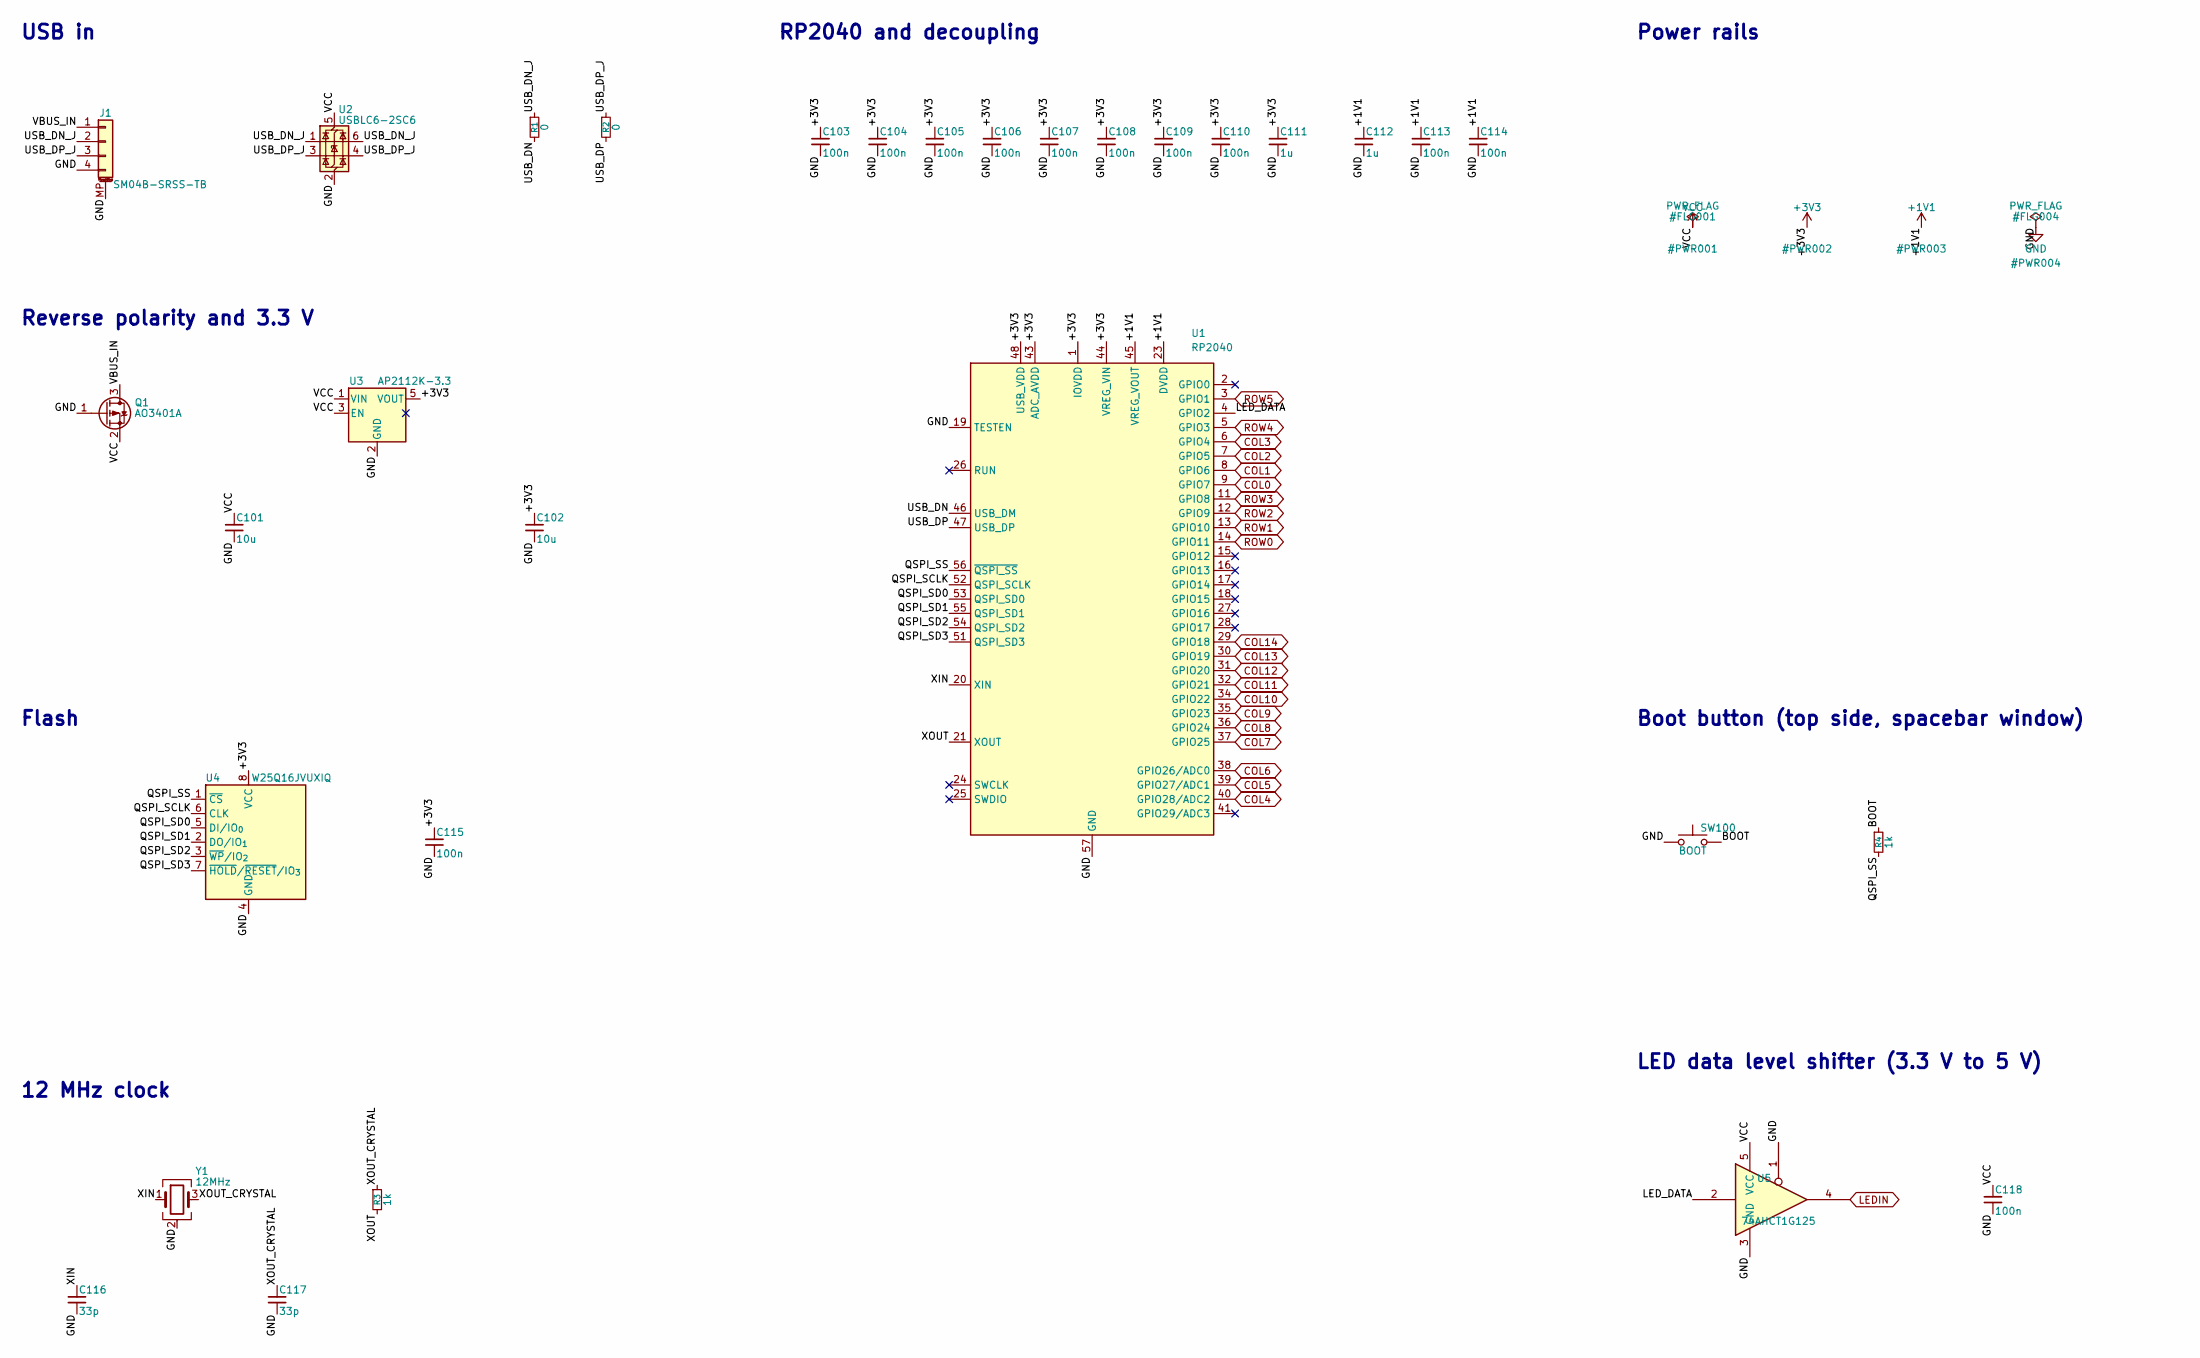
[picture p26: schematic fuji75-controller.kicad_sch]

Parts:
C101, C102: 10u; C_0603_1608Metric; MPN CL10A106KP8NNNC; LCSC C19702
C103, C104, C105, C106, C107, C108, C109, C110, C113, C114, C115, C118: 100n; C_0402_1005Metric; MPN CL05B104KO5NNNC; LCSC C1525
C111, C112: 1u; C_0402_1005Metric; MPN CL05A105KA5NQNC; LCSC C52923
C116, C117: 33p; C_0402_1005Metric; MPN 0402CG330J500NT; LCSC C1562
J1: SM04B-SRSS-TB; JST_SH_SM04B-SRSS-TB_1x04-1MP_P1.00mm_Horizontal; MPN SM04B-SRSS-TB(LF)(SN); LCSC C160404
Q1: AO3401A; SOT-23; MPN AO3401A; LCSC C15127
R1, R2: 0; R_0402_1005Metric; MPN 0402WGF0000TCE; LCSC C17168
R3, R4: 1k; R_0402_1005Metric; MPN 0402WGF1001TCE; LCSC C11702
SW100: BOOT; SW_Push_1P1T_XKB_TS-1187A; MPN TS-1187A-B-A-B; LCSC C318884
U1: RP2040; QFN-56-1EP_7x7mm_P0.4mm_EP3.2x3.2mm; MPN RP2040; LCSC C2040
U2: USBLC6-2SC6; SOT-23-6; MPN USBLC6-2SC6; LCSC C7519
U3: AP2112K-3.3; SOT-23-5; MPN AP2112K-3.3TRG1; LCSC C51118
U4: W25Q16JVUXIQ; Winbond_USON-8-1EP_3x2mm_P0.5mm_EP0.2x1.6mm; MPN W25Q16JVUXIQ; LCSC C2843335
U5: 74AHCT1G125; SOT-23-5; MPN SN74AHCT1G125DBVR; LCSC C7484
Y1: 12MHz; Crystal_SMD_3225-4Pin_3.2x2.5mm; MPN X322512MSB4SI; LCSC C9002

Connections:
+1V1: C112.1, C113.1, C114.1, U1.23 (DVDD), U1.45 (VREG_VOUT), U1.50 (DVDD)
+3V3: C102.1, C103.1, C104.1, C105.1, C106.1, C107.1, C108.1, C109.1, C110.1, C111.1, C115.1, U1.1 (IOVDD), U1.10 (IOVDD), U1.22 (IOVDD), U1.33 (IOVDD), U1.42 (IOVDD), U1.43 (ADC_AVDD), U1.44 (VREG_VIN), U1.48 (USB_VDD), U1.49 (IOVDD), U3.5 (VOUT), U4.8 (VCC)
/Controller/BOOT: R4.1, SW100.2
/Controller/LED_DATA: U1.4 (GPIO2), U5.2
/Controller/QSPI_SCLK: U1.52 (QSPI_SCLK), U4.6 (CLK)
/Controller/QSPI_SD0: U1.53 (QSPI_SD0), U4.5 (DI/IO_{0})
/Controller/QSPI_SD1: U1.55 (QSPI_SD1), U4.2 (DO/IO_{1})
/Controller/QSPI_SD2: U1.54 (QSPI_SD2), U4.3 (~WP/IO_{2})
/Controller/QSPI_SD3: U1.51 (QSPI_SD3), U4.7 (~HOLD/~RESET/IO_{3})
/Controller/QSPI_SS: R4.2, U1.56 (~QSPI_SS), U4.1 (~CS)
/Controller/USB_DN: R1.2, U1.46 (USB_DM)
/Controller/USB_DN_J: J1.2, R1.1, U2.1 (I/O1), U2.6 (I/O1)
/Controller/USB_DP: R2.2, U1.47 (USB_DP)
/Controller/USB_DP_J: J1.3, R2.1, U2.3 (I/O2), U2.4 (I/O2)
/Controller/VBUS_IN: J1.1, Q1.3 (D)
/Controller/XIN: C116.1, U1.20 (XIN), Y1.1
/Controller/XOUT: R3.2, U1.21 (XOUT)
/Controller/XOUT_CRYSTAL: C117.1, R3.1, Y1.3
COL0: U1.9 (GPIO7); also elsewhere on the board
COL1: U1.8 (GPIO6); also elsewhere on the board
COL2: U1.7 (GPIO5); also elsewhere on the board
COL3: U1.6 (GPIO4); also elsewhere on the board
COL4: U1.40 (GPIO28/ADC2); also elsewhere on the board
COL5: U1.39 (GPIO27/ADC1); also elsewhere on the board
COL6: U1.38 (GPIO26/ADC0); also elsewhere on the board
COL7: U1.37 (GPIO25); also elsewhere on the board
COL8: U1.36 (GPIO24); also elsewhere on the board
COL9: U1.35 (GPIO23); also elsewhere on the board
COL10: U1.34 (GPIO22); also elsewhere on the board
COL11: U1.32 (GPIO21); also elsewhere on the board
COL12: U1.31 (GPIO20); also elsewhere on the board
COL13: U1.30 (GPIO19); also elsewhere on the board
COL14: U1.29 (GPIO18); also elsewhere on the board
GND: C101.2, C102.2, C103.2, C104.2, C105.2, C106.2, C107.2, C108.2, C109.2, C110.2, C111.2, C112.2, C113.2, C114.2, C115.2, C116.2, C117.2, C118.2, J1.4, J1.MP (MountPin), Q1.1 (G), SW100.1, U1.19 (TESTEN), U1.57 (GND), U2.2 (GND), U3.2 (GND), U4.4 (GND), U5.1, U5.3 (GND), Y1.2 (G), Y1.4 (G); also elsewhere on the board
LEDIN: U5.4; also elsewhere on the board
ROW0: U1.14 (GPIO11); also elsewhere on the board
ROW1: U1.13 (GPIO10); also elsewhere on the board
ROW2: U1.12 (GPIO9); also elsewhere on the board
ROW3: U1.11 (GPIO8); also elsewhere on the board
ROW4: U1.5 (GPIO3); also elsewhere on the board
ROW5: U1.3 (GPIO1); also elsewhere on the board
VCC: C101.1, C118.1, Q1.2 (S), U2.5 (VBUS), U3.1 (VIN), U3.3 (EN), U5.5 (VCC); also elsewhere on the board

Notes on the sheet:
USB in
Reverse polarity and 3.3 V
RP2040 and decoupling
Flash
12 MHz clock
Power rails
Boot button (top side, spacebar window)
LED data level shifter (3.3 V to 5 V)

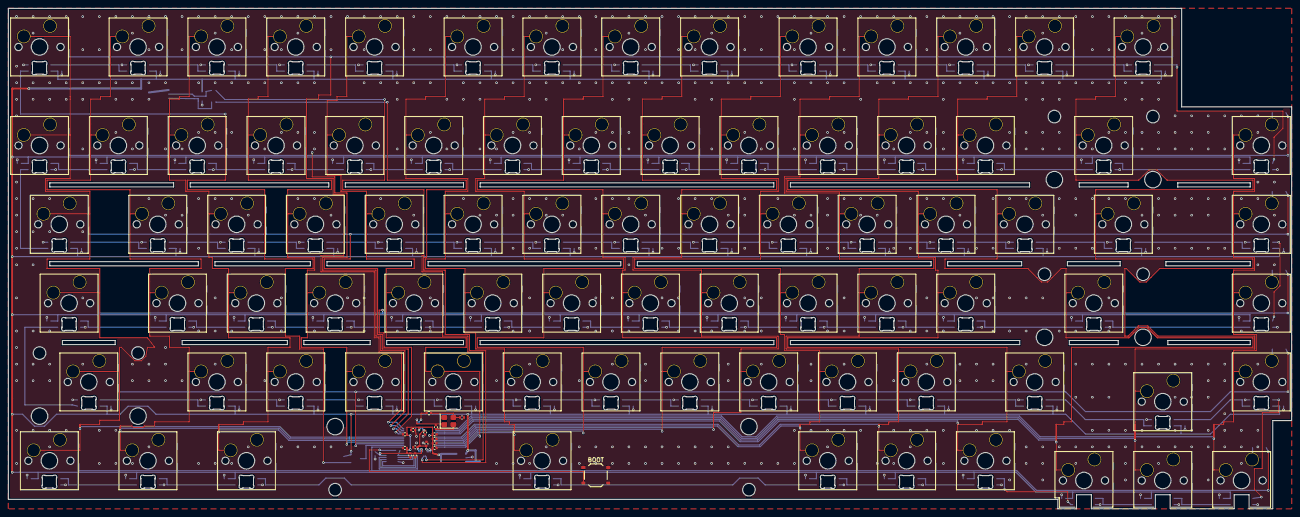
[picture p27: board fuji75.kicad_pcb from above]

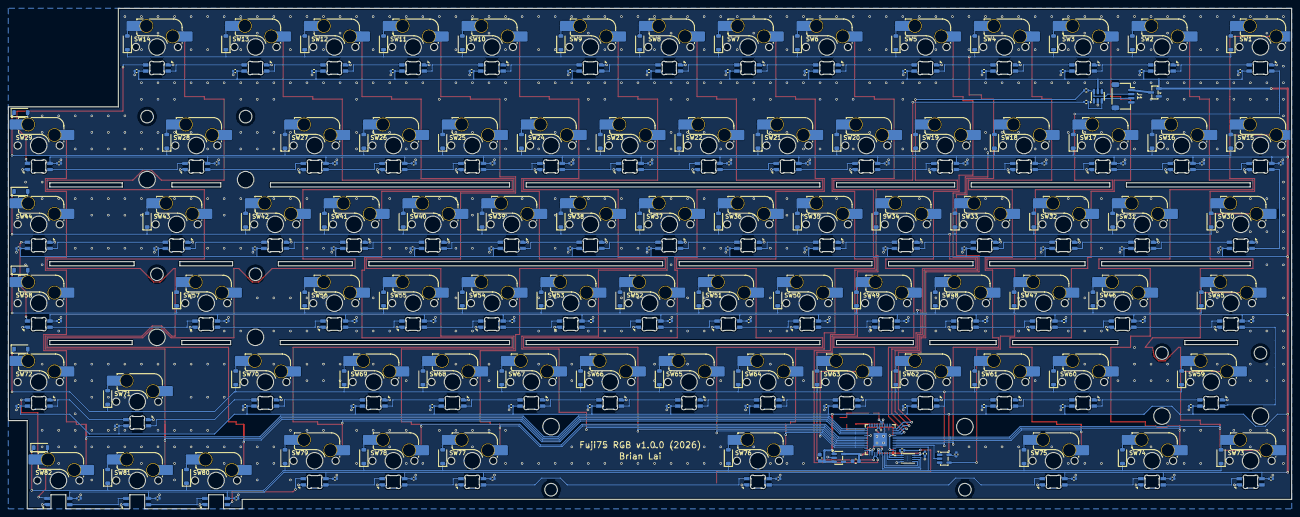
[picture p28: board fuji75.kicad_pcb from below]

Board: 2 copper layers, 310.1 x 120.9 mm, 363 parts (342 on the bottom side), 205 nets.
