blai30/pcbs/(commit log)

2026-11-05 Set up repo for PCB designs
2026-11-05 Add Fuji75 PCB reference measurements and photos
2026-11-05 Add original plate source
    [fuji75_plate.dxf]
2026-11-05 Add Fuji75 key grid generator and KiCad project
    [fuji75-key-matrix.kicad_sch, fuji75-led-chain.kicad_sch, fuji75.kicad_pcb, fuji75.kicad_sch]
2026-11-05 Notch arrow LED cutouts into the board edge
    [fuji75-key-matrix.kicad_sch, fuji75-led-chain.kicad_sch, fuji75.kicad_pcb, fuji75.kicad_sch]
2026-11-05 Start the F-row flex cut past the controller
    [fuji75-key-matrix.kicad_sch, fuji75-led-chain.kicad_sch, fuji75.kicad_pcb, fuji75.kicad_sch]
2026-11-05 Add the controller circuit
    [fuji75-controller.kicad_sch, fuji75.kicad_pcb, fuji75.kicad_sch]
2026-11-05 Document the controller pin map and boot button
2026-11-05 Set white solder mask and black silkscreen
    [fuji75.kicad_pcb]
2026-11-05 Remove the F-row flex cut and merge short cut pieces
    [fuji75.kicad_pcb]
2026-11-05 Move diodes and LED capacitors for routing
    [fuji75.kicad_pcb]
2026-11-05 Move the controller under the spacebar and remap GPIOs
    [fuji75-controller.kicad_sch, fuji75.kicad_pcb]
2026-11-05 Route the board
    [fuji75.kicad_pcb]
2026-11-05 Add switch outlines and branding to the silkscreen
    [fuji75.kicad_pcb]
2026-11-05 Add part numbers
    [fuji75-controller.kicad_sch, fuji75-key-matrix.kicad_sch, fuji75-led-chain.kicad_sch, fuji75.kicad_pcb]
2026-11-05 Add fab notes and the new pin map
    [fuji75.kicad_pcb]
2026-11-05 Show lock states on the Caps and F11 LEDs
2026-11-05 Add screw head keepouts to the stabilizer footprints
2026-11-05 Clear stabilizer holes and move ESD VBUS behind the MOSFET
    [fuji75-controller.kicad_sch, fuji75.kicad_pcb]
2026-11-05 Add the PCBWay order form guide
2026-11-06 Narrow the RP2040 pads for white solder mask and keep ground fill off LED cutouts
    [fuji75.kicad_pcb]
2026-11-06 Add JLCPCB order files and guide, and center socket placement on the socket
2026-11-09 Require genuine Kailh hotswap sockets in the PCBWay assembly notes
2026-11-09 Add an FR4 switch plate generated from the stock plate DXF and PCB footprints
    [fuji75-plate.kicad_pcb]
2026-11-10 Add a plate foam DXF and PDF generated from the PCB footprints
    [fuji75-plate-foam.dxf]
2026-11-10 Remove the plate flex cuts and slots by default
    [fuji75-plate.kicad_pcb]
